bobbyjsmith11/mb-lna/ship/revA/505-201-A1-SCH.pdf

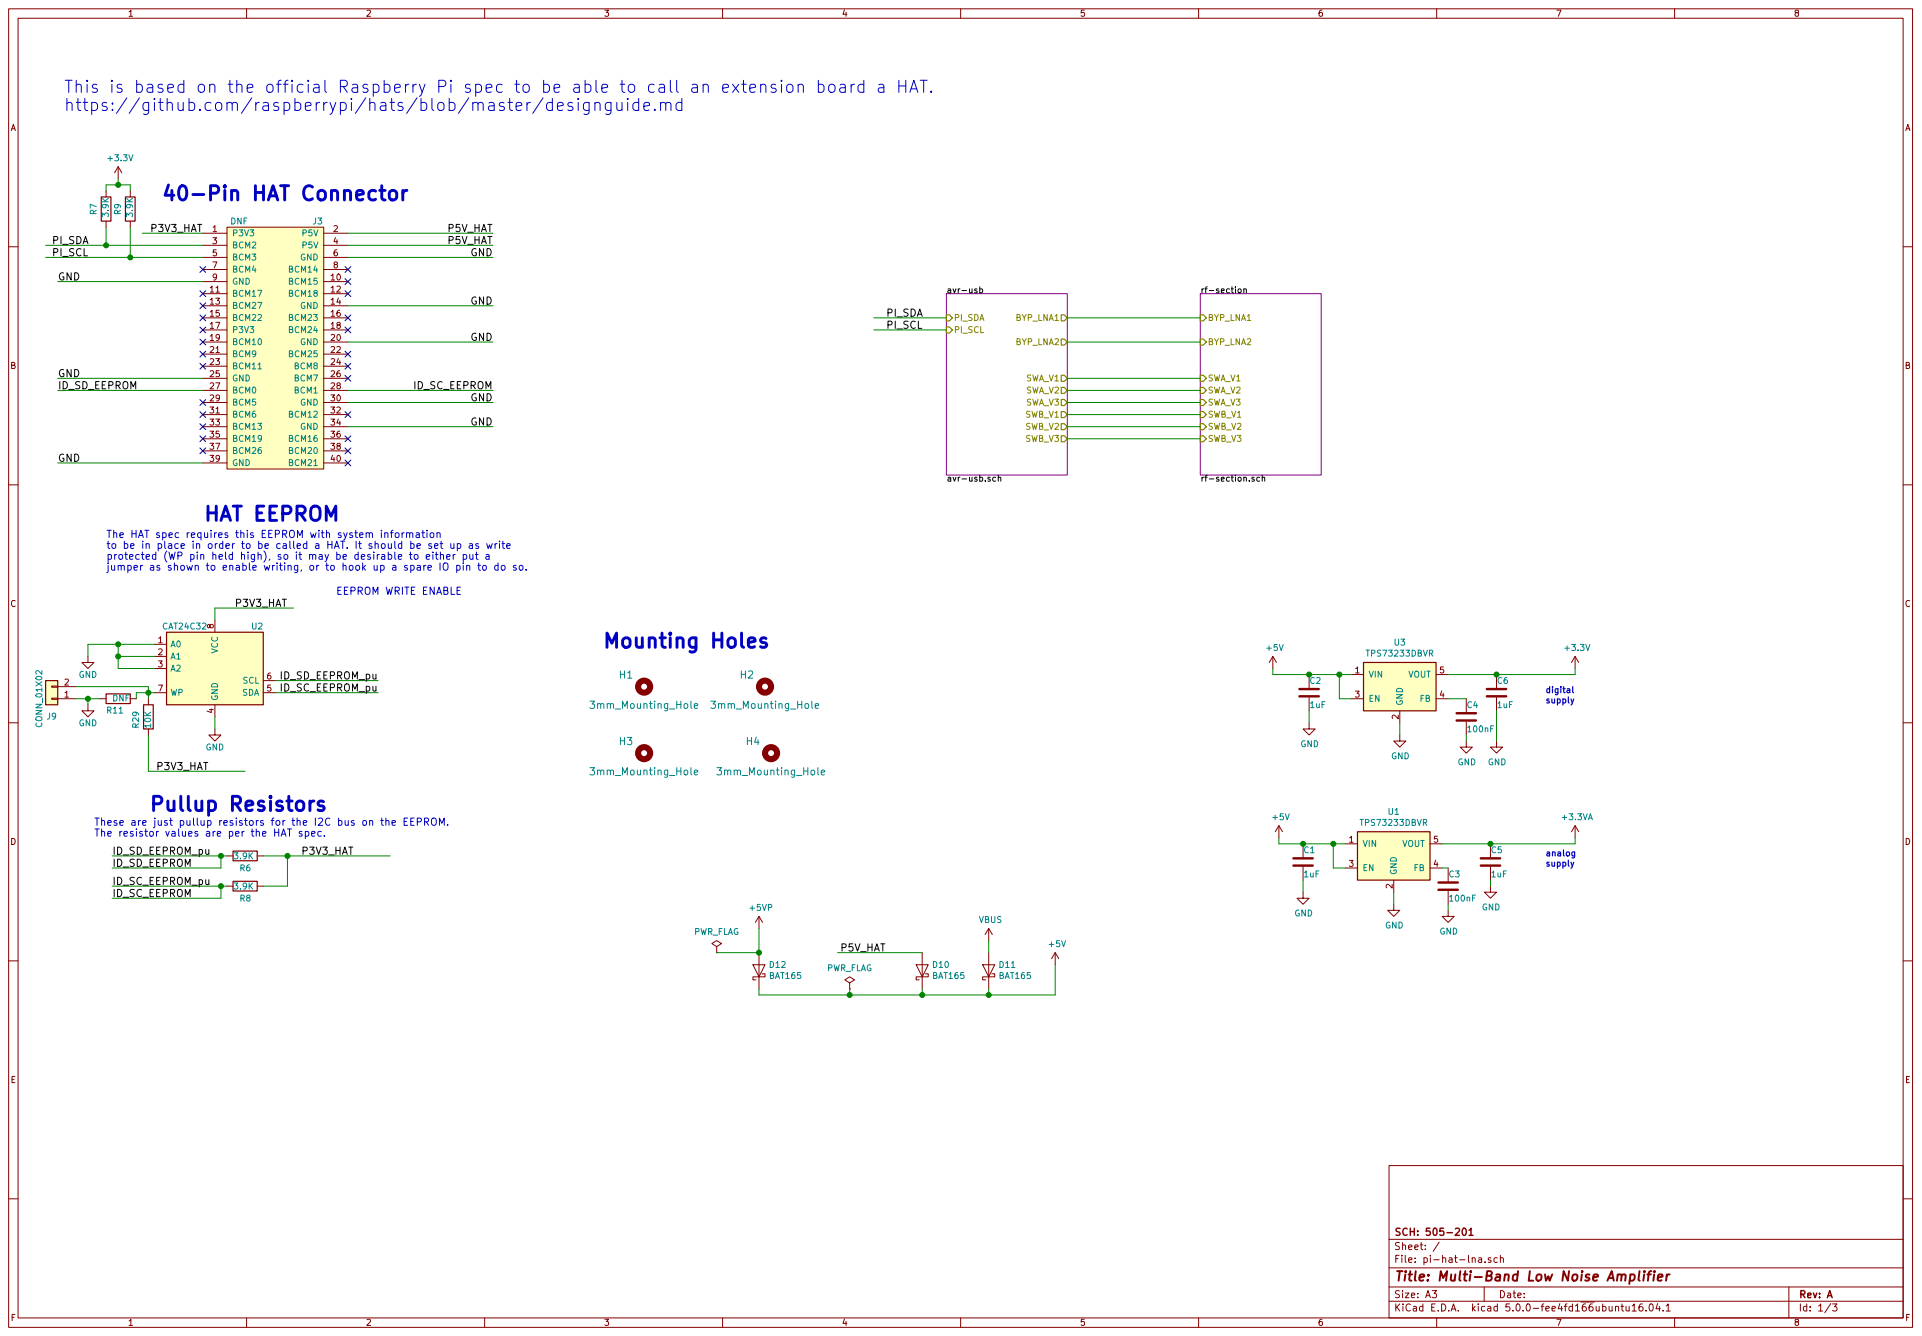
[picture p1: page 1]

This is based on the official Raspberry Pi spec to be able to call an extension board a HAT.
https://github.com/raspberrypi/hats/blob/master/designguide.md

The HAT spec requires this EEPROM with system information
to be in place in order to be called a HAT. It should be set up as write
protected (WP pin held high), so it may be desirable to either put a
jumper as shown to enable writing, or to hook up a spare IO pin to do so.

These are just pullup resistors for the I2C bus on the EEPROM.
The resistor values are per the HAT spec.
ID_SD_EEPROM_pu
ID_SD_EEPROM
ID_SC_EEPROM_pu
ID_SC_EEPROM

File: pi-hat-lna.sch Sheet: / SCH: 505-201

Id: 1/3 Title: Multi-Band Low Noise Amplifier

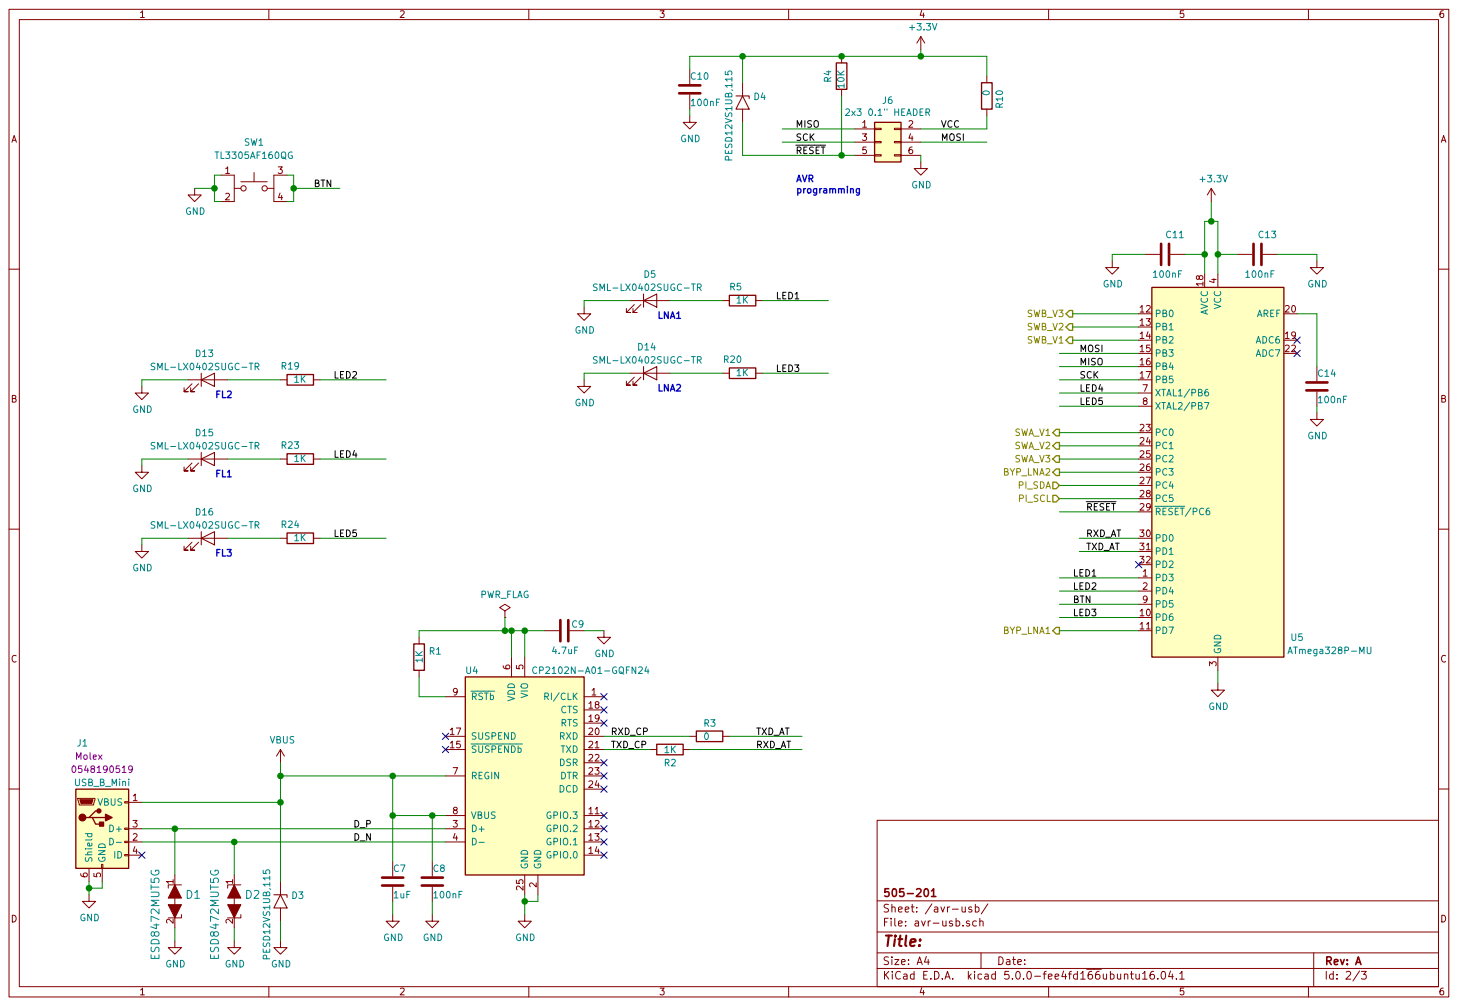
[picture p2: page 2]

6 REGIN 7 VBUS 8 RSTb 9 U4 CP2102N-A01-GQFN24 D_P D_N GND

2 RXD 20 TXD 21 DSR 22 DTR 23 DCD 24 GND 25 D+ 3 D- 4 VIO

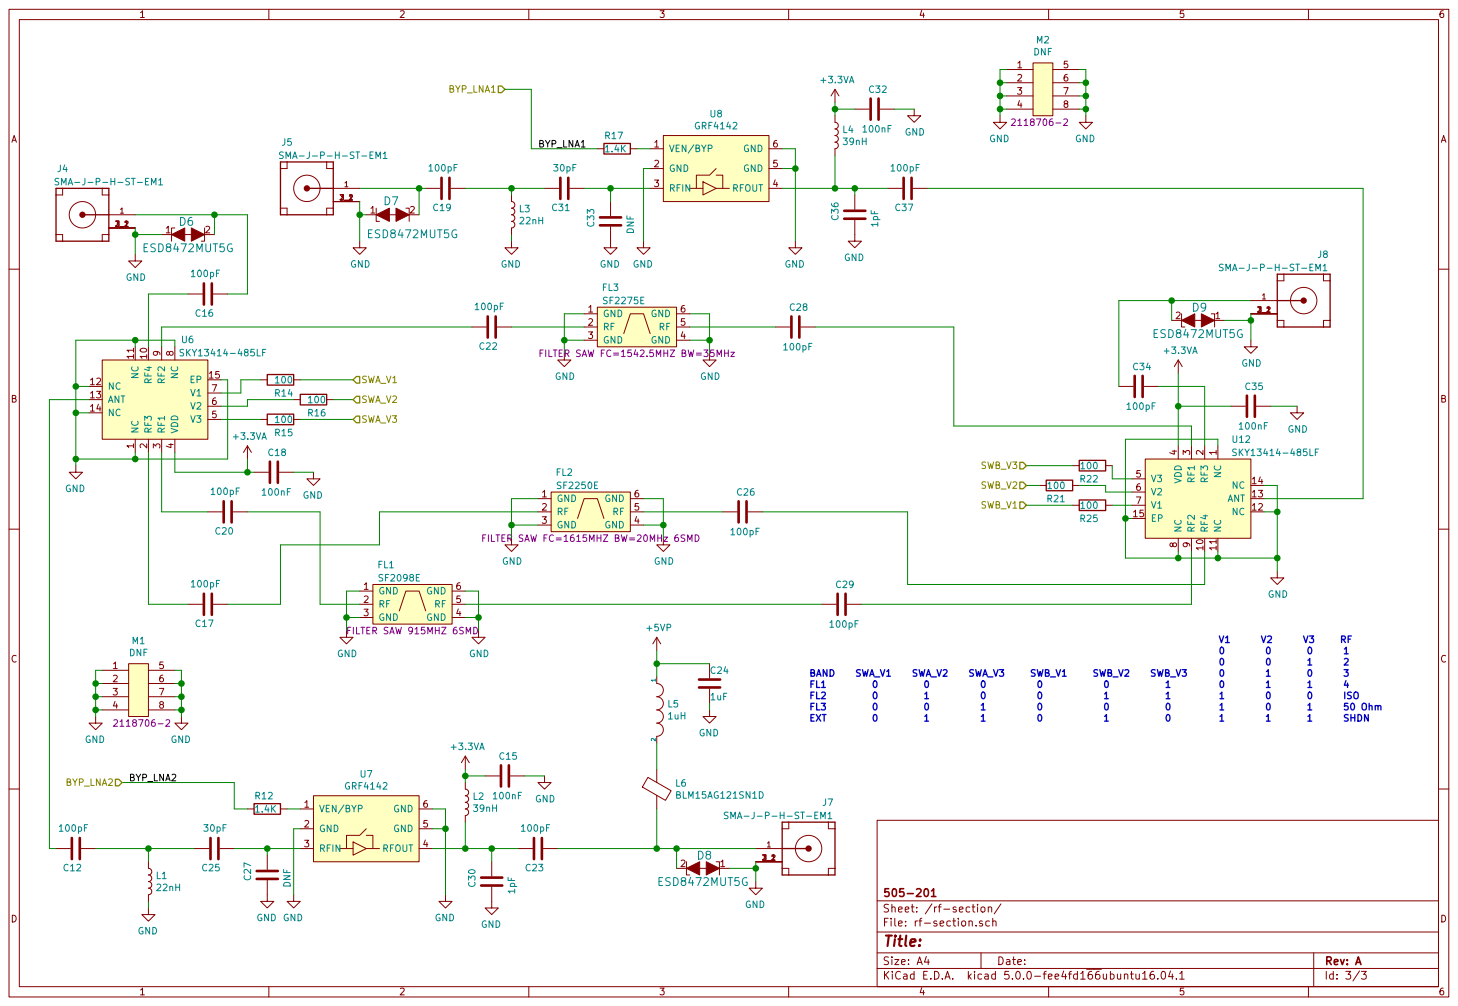
[picture p3: page 3]

FILTER SAW FC=1542.5MHZ BW=35MHz C23

1 RF4 10 NC 11 NC 12 ANT 13 NC 14 EP 15 RF3
