bobbyjsmith11/mb-lna/ship/revA/505-201-A1-ASSY.pdf

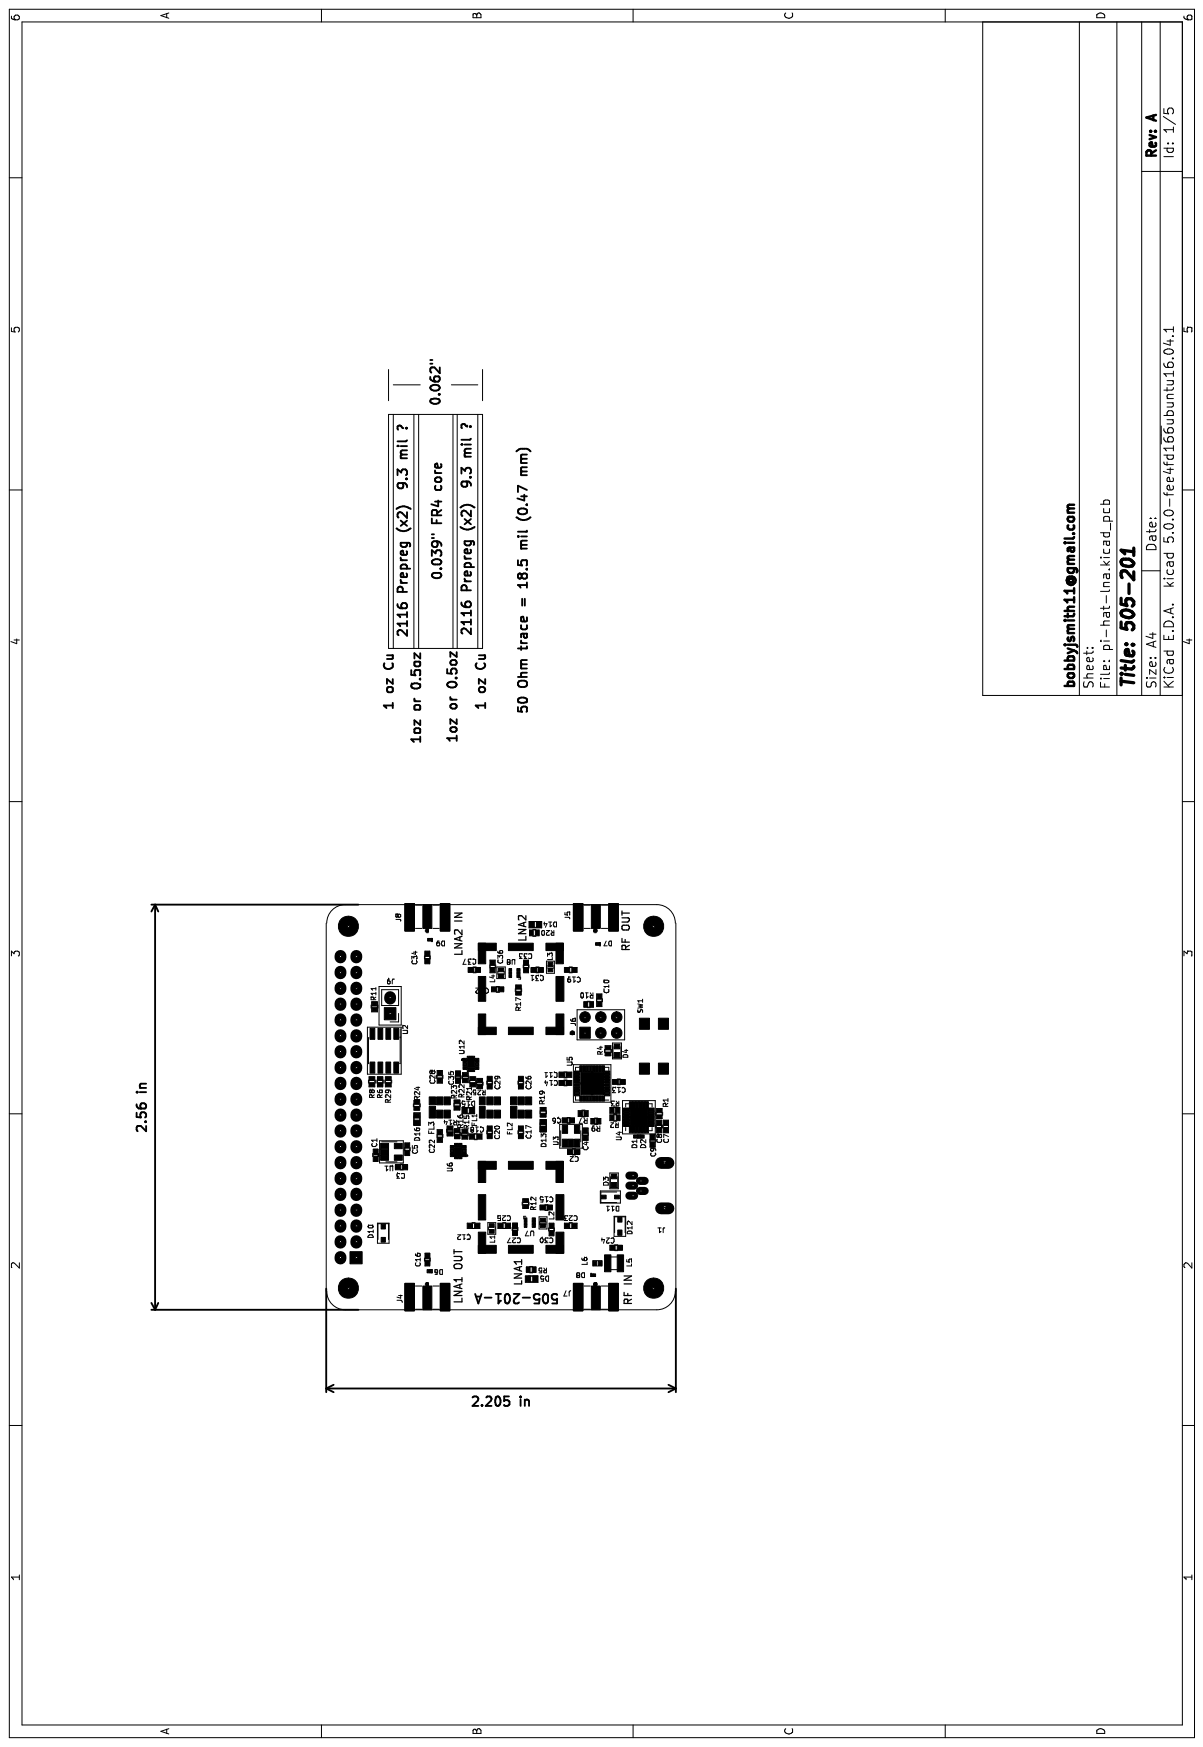
[picture p4: page 1]
