bobbyjsmith11/mb-lna/pi-hat-lna.kicad_pcb

## KiCad design pi-hat-lna.kicad_pcb (2018-11-04)

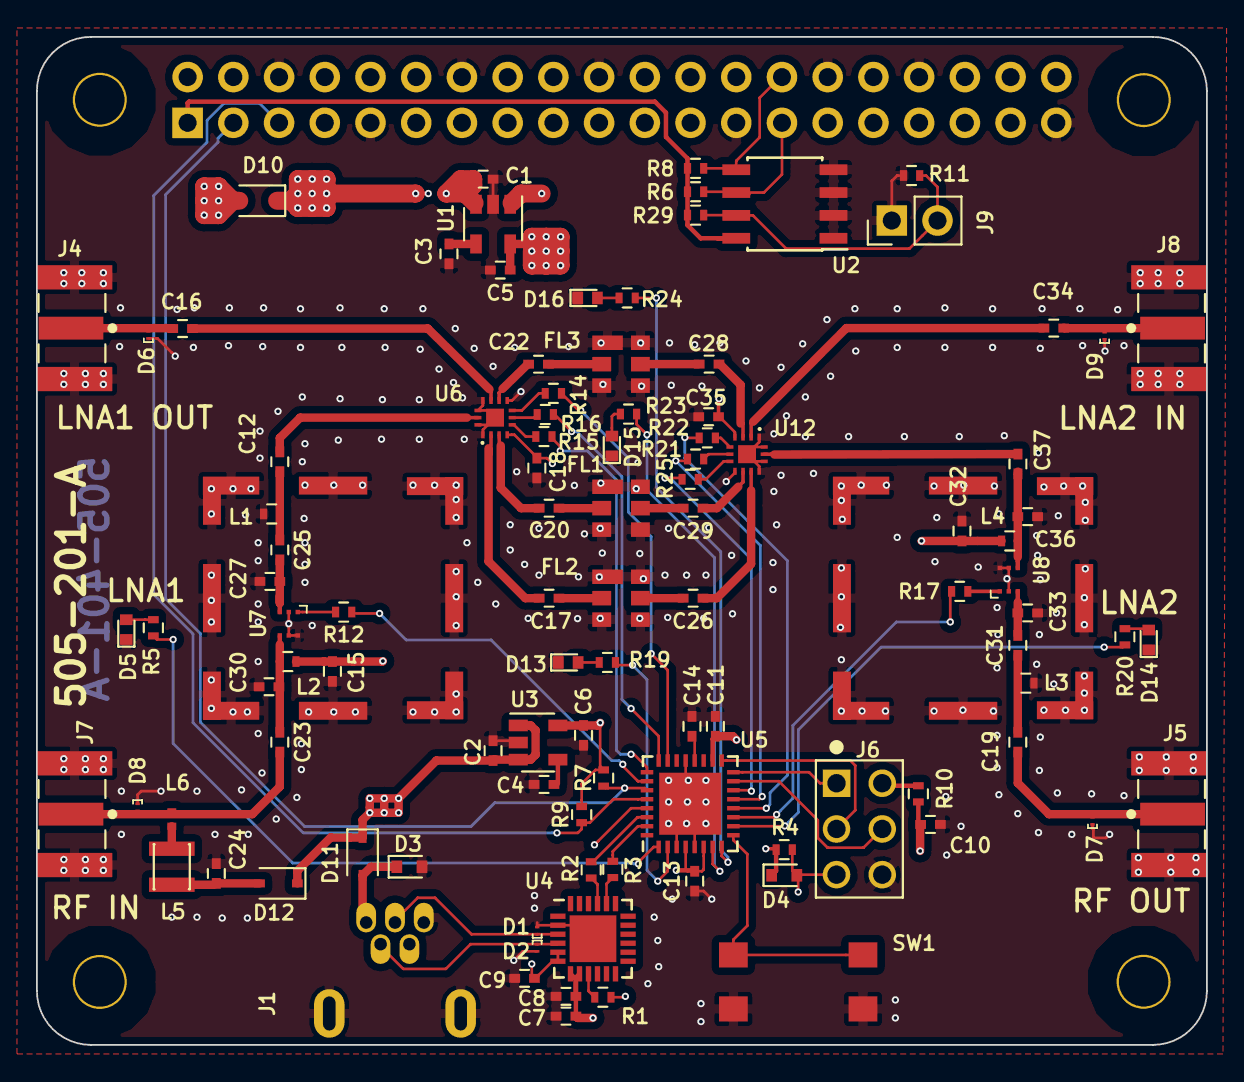
[picture p5: board pi-hat-lna.kicad_pcb from above]

Board: 4 copper layers, 65.0 x 56.0 mm, 109 parts (1 on the bottom side), 83 nets.

Parts:
C1, C2, C5, C6, C7, C24: 1uF; C_0402
C3, C4, C8, C10, C11, C13, C14, C15, C18, C32, C35: 100nF; C_0402
C9: 4.7uF; C_0402
C12, C16, C17, C19, C20, C22, C23, C26, C28, C29, C34, C37: 100pF; C_0402
C25, C31: 30pF; C_0402
C27, C33: DNF; C_0402
C30, C36: 1pF; C_0402
D1, D2, D6, D7, D8, D9: ESD8472MUT5G; ONSEMI_0201_DSN2_153AF
D3, D4: PESD12VS1UB,115; D_SOD-523
D5, D13, D14, D15, D16: SML-LX0402SUGC-TR; LED_0402
D10, D11, D12: BAT165; D_SOD-323
FL1: SF2098E; SAW_3X3mm
FL2: SF2250E; SAW_3X3mm
FL3: SF2275E; SAW_3X3mm
H1, H2, H3, H4: 3mm_Mounting_Hole; NPTH_3mm_ID
J1: USB_B_Mini; USB_Mini-B_Molex-054819-0519
J3: DNF; PinSocket_2x20_P2.54mm_Vertical
J4, J5, J7, J8: SMA-J-P-H-ST-EM1
J6: 2x3 0.1" HEADER; FRAMATOME_67997-206HLF
J9: CONN_01X02; PinHeader_1x02_P2.54mm_Vertical
L1, L3: 22nH; L_0402
L2, L4: 39nH; L_0402
L5: 1uH; INDC2520X100
L6: BLM15AG121SN1D; FB_0402_NoSilk
M1, M2: DNF; 2118706-2
R1, R2, R5, R19, R20, R23, R24: 1K; R_0402
R3, R10: 0; R_0402
R4, R29: 10K; R_0402
R6, R7, R8, R9: 3.9K; R_0402
R11: DNF; R_0402
R12, R17: 1.4K; R_0402
R14, R15, R16, R21, R22, R25: 100; R_0402
SW1: TL3305AF160QG
U1, U3: TPS73233DBVR; SOT-23-5
U2: CAT24C32; SOIC-8_3.9x4.9mm_P1.27mm
U4: CP2102N-A01-GQFN24; QFN-24-1EP_4x4mm_Pitch0.5mm
U5: ATmega328P-MU; QFN-32-1EP_5x5mm_Pitch0.5mm
U6, U12: SKY13414-485LF; QFN45P200X200X55-15N
U7, U8: GRF4142; DFN1.5MMX1.5MMX0.45MM-6

Connections:
+3.3VA: C5.1, C15.2, C18.2, C32.2, C35.2, L2.1, L4.1, U1.5, U6.4, U12.4
+3V3: C6.1, C10.1, C11.1, C13.2, D4.1, R4.2, R7.2, R9.2, R10.2, U3.5, U5.4, U5.6, U5.18
+5V: C1.1, C2.1, D10.1, D11.1, D12.1, U1.1, U1.3, U3.1, U3.3
+5VP: C24.1, D12.2, L5.1
/ID_SC_EEPROM: J3.28, R8.2, U2.5
/ID_SD_EEPROM: J3.27, R6.2, U2.6
/P3V3_HAT: J3.1, R6.1, R8.1, R29.1, U2.8
/P5V_HAT: D10.2, J3.2, J3.4
/PI_SCL: J3.5, R9.1, U5.28
/PI_SDA: J3.3, R7.1, U5.27
/avr-usb/BTN: SW1.3, SW1.4, U5.9
/avr-usb/BYP_LNA1: R17.2, U5.11
/avr-usb/BYP_LNA2: R12.2, U5.26
/avr-usb/D_N: D2.1, J1.2, U4.4
/avr-usb/D_P: D1.1, J1.3, U4.3
/avr-usb/LED1: R5.2, U5.1
/avr-usb/LED2: R19.2, U5.2
/avr-usb/LED3: R20.2, U5.10
/avr-usb/LED4: R23.2, U5.7
/avr-usb/LED5: R24.2, U5.8
/avr-usb/MISO: J6.1, U5.16
/avr-usb/MOSI: J6.4, U5.15
/avr-usb/RXD_AT: R2.1, U5.30
/avr-usb/RXD_CP: R3.2, U4.20
/avr-usb/SCK: J6.3, U5.17
/avr-usb/SWA_V1: R14.1, U5.23
/avr-usb/SWA_V2: R16.1, U5.24
/avr-usb/SWA_V3: R15.1, U5.25
/avr-usb/SWB_V1: R25.1, U5.14
/avr-usb/SWB_V2: R21.1, U5.13
/avr-usb/SWB_V3: R22.1, U5.12
/avr-usb/TXD_AT: R3.1, U5.31
/avr-usb/TXD_CP: R2.2, U4.21
/avr-usb/VCC: J6.2, R10.1
/avr-usb/~RESET: D4.2, J6.5, R4.1, U5.29
GND: C1.2, C2.2, C3.2, C4.2, C5.2, C6.2, C7.2, C8.2, C9.1, C10.2, C11.2, C13.1, C14.2, C15.1, C18.1, C24.2, C27.2, C30.2, C32.1, C33.2, C35.1, C36.2, D1.2, D2.2, D3.2, D5.1, D6.1, D7.1, D8.1, D9.1, D13.1, D14.1, D15.1, D16.1, FL1.1, FL1.3, FL1.4, FL1.6, FL2.1, FL2.3, FL2.4, FL2.6, FL3.1, FL3.3, FL3.4, FL3.6, J1.5, J1.6, J3.6, J3.9, J3.14, J3.20, J3.25, J3.30, J3.34, J3.39, J4.2_1, J4.2_2, J4.3_1, J4.3_2, J5.2_1, J5.2_2, J5.3_1, J5.3_2, J6.6, J7.2_1, J7.2_2, J7.3_1, J7.3_2, J8.2_1, J8.2_2, J8.3_1, J8.3_2, J9.1, L1.2, L3.2, M1.1, M1.2, M1.3, M1.4, M1.5, M1.6, M1.7, M1.8, M2.1, M2.2, M2.3, M2.4, M2.5, M2.6, M2.7, M2.8, R11.1, SW1.1, SW1.2, U1.2, U2.1, U2.2, U2.3, U2.4, U3.2, U4.2, U4.25, U5.3, U5.5, U5.21, U5.33, U6.1, U6.8, U6.11, U6.12, U6.14, U6.15, U7.2, U7.5, U7.6, U8.2, U8.5, U8.6, U12.1, U12.8, U12.11, U12.12, U12.14, U12.15
unnamed: C3.1, U1.4
unnamed: C4.1, U3.4
unnamed: C9.2, R1.1, U4.5, U4.6
unnamed: C12.1, U6.13
unnamed: C12.2, C25.1, L1.1
unnamed: C14.1, U5.20
unnamed: C16.1, U6.10
unnamed: C16.2, D6.2, J4.1
unnamed: C17.1, U6.2
unnamed: C17.2, FL2.2
unnamed: C19.1, D7.2, J5.1
unnamed: C19.2, C31.1, L3.1
unnamed: C20.1, U6.3
unnamed: C20.2, FL1.2
unnamed: C22.1, U6.9
unnamed: C22.2, FL3.2
unnamed: C23.1, C30.1, L2.2, U7.4
unnamed: C23.2, D8.2, J7.1, L6.2
unnamed: C25.2, C27.1, U7.3
unnamed: C26.1, U12.10
unnamed: C26.2, FL2.5
unnamed: C28.1, U12.3
unnamed: C28.2, FL3.5
unnamed: C29.1, U12.9
unnamed: C29.2, FL1.5
unnamed: C31.2, C33.1, U8.3
unnamed: C34.1, U12.2
unnamed: C34.2, D9.2, J8.1
unnamed: C36.1, C37.1, L4.2, U8.4
unnamed: C37.2, U12.13
unnamed: D5.2, R5.1
unnamed: D13.2, R19.1
unnamed: D14.2, R20.1
unnamed: D15.2, R23.1
unnamed: D16.2, R24.1
unnamed: J9.2, R11.2, R29.2, U2.7
unnamed: L5.2, L6.1
unnamed: R1.2, U4.9
unnamed: R12.1, U7.1
unnamed: R14.2, U6.7
unnamed: R15.2, U6.5
unnamed: R16.2, U6.6
unnamed: R17.1, U8.1
unnamed: R21.2, U12.6
unnamed: R22.2, U12.5
unnamed: R25.2, U12.7
VBUS: C7.1, C8.1, D3.1, D11.2, J1.1, U4.7, U4.8
