bobbyjsmith11/mb-lna/(commit log)

2018-08-19 Need yet to add the AVR programming connector and the RF filters
    [cp2102-atmega.sch, lna_w_bypass.sch, mb-lna.sch, rf_section.sch]
2018-08-19 Schematic complete. Ready for review.
    [cp2102-atmega.sch, mb-lna.sch, rf_section.sch]
2018-08-19 More updates. Added LED to AVR to help with bring up and debug.
    [cp2102-atmega.sch, rf_section.sch]
2018-08-21 Started parts placement and fixed some RF routing to accomodate layout
    [cp2102-atmega.sch, mb-lna.kicad_pcb, rf_section.sch]
2018-08-23 added the netlist and BOM
    [mb-lna_bom_A.csv]
2018-08-23 Added 3D model for usb mini connector
    [mb-lna.kicad_pcb]
2018-08-25 Changed design to be a pi-hat
    [avr-usb.sch, cp2102_batt_chg.sch, mb-lna.kicad_pcb, mb-lna.sch, mb-lna_bom_A.csv, pi-hat-lna.kicad_pcb, pi-hat-lna.sch, rf-section.sch]
2018-08-26 Almost all 3D models have been added. Rough parts placement complete.
    [avr-usb.sch, pi-hat-lna.kicad_pcb, pi-hat-lna.sch, rf-section.sch]
2018-08-27 Added 3D models to project library
    [pi-hat-lna.kicad_pcb]
2018-09-03 Trimmed unnecessary parts from the Pi power circuitry. Now the Pi 5V is diode or'd with VBUS from the USB
    [avr-usb.sch, pi-hat-lna.kicad_pcb, pi-hat-lna.sch, rf-section.sch]
2018-09-09 Can now power via: 1. USB 2. R-Pi 3. Bias TEE
    [avr-usb.sch, pi-hat-lna.kicad_pcb, pi-hat-lna.sch, rf-section.sch]
2018-10-11 Finally have the stackup
    [avr-usb.sch, pi-hat-lna.kicad_pcb, pi-hat-lna.sch, rf-section.sch]
2018-10-14 I think the layout is ready for review
    [avr-usb.sch, pi-hat-lna.kicad_pcb, pi-hat-lna.sch, rf-section.sch]
2018-10-19 Cleaned up BOM and added part numbers to the layout.
    [avr-usb.sch, pi-hat-lna.kicad_pcb, pi-hat-lna.sch, rf-section.sch]
2018-10-19 Cleaned up all vias and tracks. FYI - always work in mils!!!
    [pi-hat-lna.kicad_pcb]
2018-10-20 Board is out for quote to several places.
    [505-201-A-BOM.csv, pi-hat-lna.kicad_pcb, rf-section.sch]
2018-10-21 The project footprints have been locally archived now. Now, all of the footprints are loacl within the project.
    [avr-usb.sch, pi-hat-lna.kicad_pcb, pi-hat-lna.sch, rf-section.sch]
2018-10-23 More dicking around with CMs
    [505-201-A-BOM.csv, pi-hat-lna.sch, rf-section.sch]
2018-10-24 Updated the I2C lines from the R-pi to connect to the appropriate pins on the ATMEGA328P: SDA - pin 27 (PC4) SCL - pin 28 (PC5) Also, updated the layout accordingly.
    [avr-usb.sch, pi-hat-lna.kicad_pcb]
2018-10-24 PCBWay has agreed to do the stackup called out on the drawing. I've updated the schematic and layout accounting for the I2C changes related to the AtMega328P
    [505-201-A-BOM.csv, pi-hat-lna.kicad_pcb]
2018-11-04 fixed the board outline so that step files can be exported
    [pi-hat-lna.kicad_pcb]
